jeremynguyenn/Automotive-Electronic-Control-Unit-ECU-Hardware-and-Firmware/picture/layer2.png

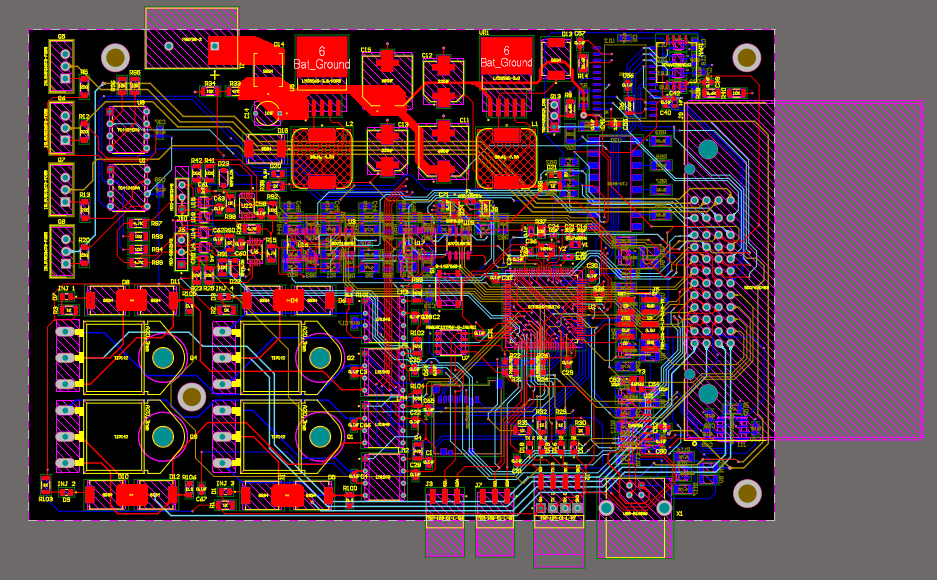
picture/layer2.png
