jeremynguyenn/Automotive-Electronic-Control-Unit-ECU-Hardware-and-Firmware/picture/layer3D.png

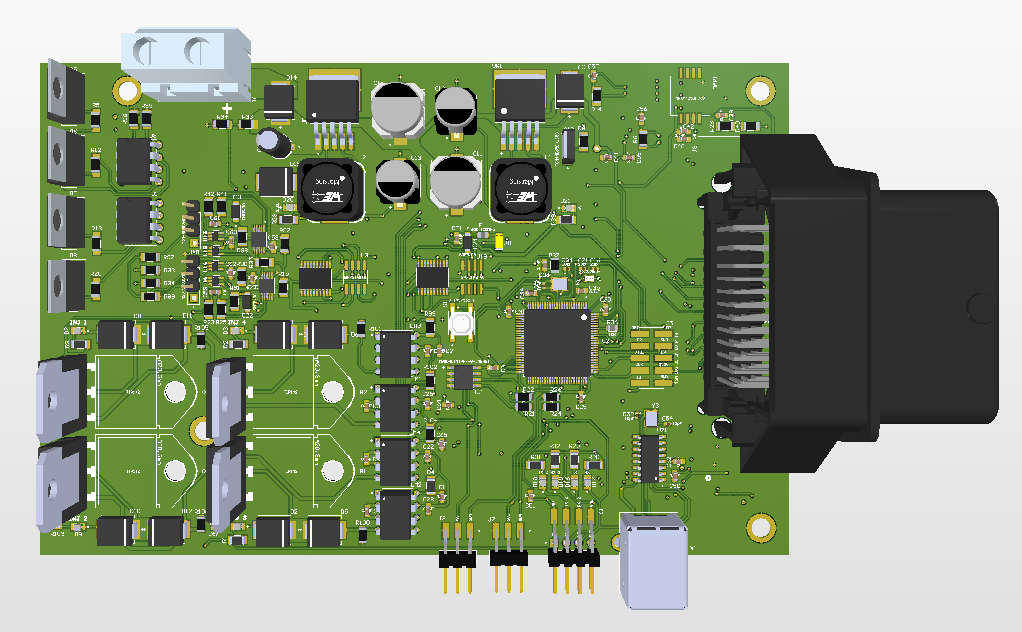
picture/layer3D.png
