jeremynguyenn/Automotive-Electronic-Control-Unit-ECU-Hardware-and-Firmware/(list of files, drawings)

Other design files:
ECU-Hardware/Analog_Sensors_Sheet.SchDoc
ECU-Hardware/CCU_Sheet.SchDoc
ECU-Hardware/Componentes/DIP794W45P254L959H508Q8.PcbLib
ECU-Hardware/Componentes/DIP794W45P254L959H508Q8.SchLib
ECU-Hardware/Display_IOT_Sheet.SchDoc
ECU-Hardware/ECTU.PrjPcb
ECU-Hardware/ECU_Sheet.SchDoc
