jeremynguyenn/Automotive-Electronic-Control-Unit-ECU-Hardware-and-Firmware/(notices)

Notices in the files:
Route-ECU-Firmware-Register-Only/Core/Src/main.c:
Copyright (c) 2025 STMicroelectronics.
All rights reserved.
This software is licensed under terms that can be found in the LICENSE file
